yumeyuu/dumbpad/hotswap_rgb_v2/3dmodel/RotarryEncoder_EC12-SW.step

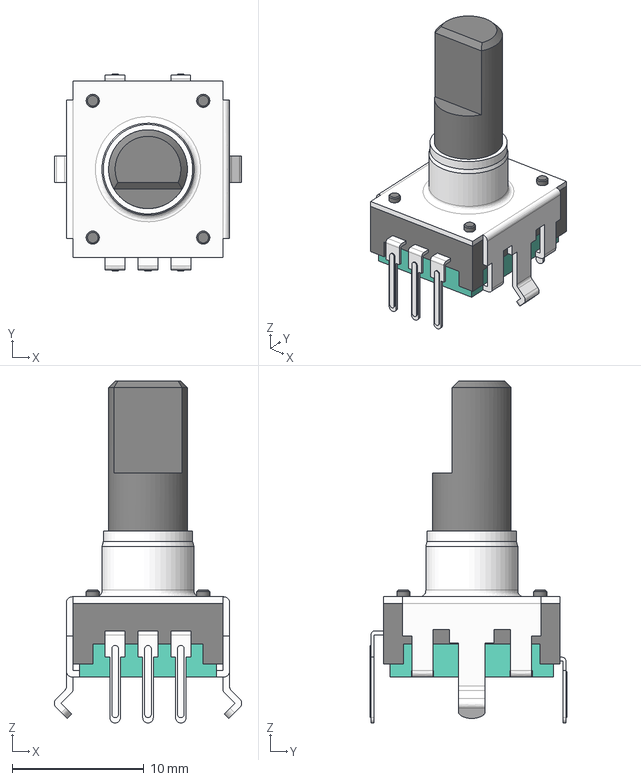
[picture p8: CAD file, 2024-03-14]
hotswap_rgb_v2/3dmodel/RotarryEncoder_EC12-SW.step
14.2 x 15.0 x 26.0 mm
