yumeyuu/dumbpad/hotswap_rgb_v2/3dmodel/OLED-Module-with-Pins.step

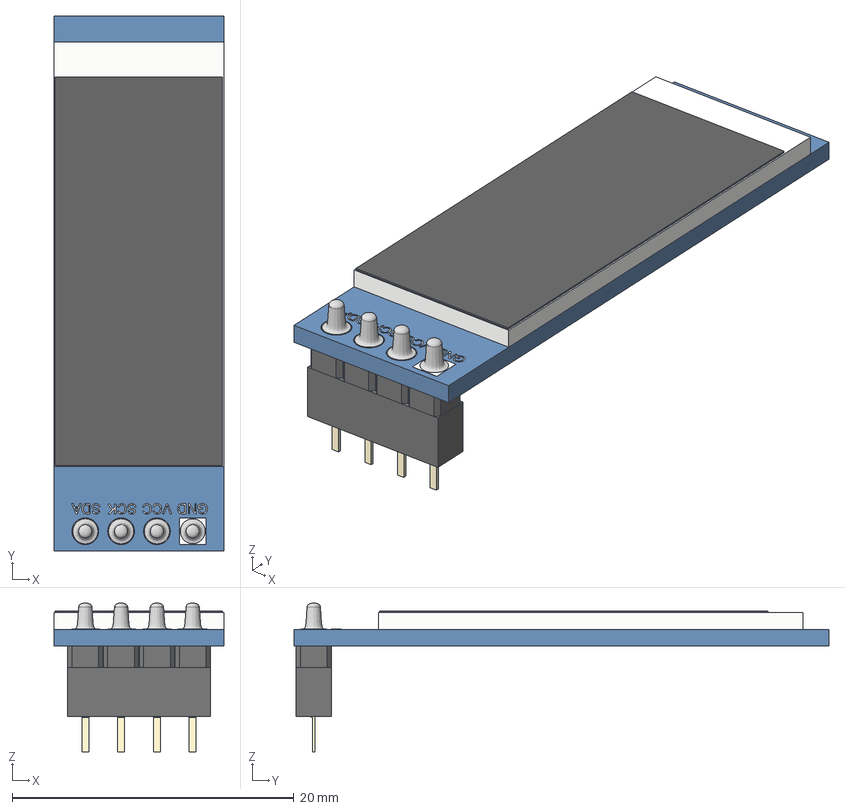
[picture p9: CAD file, 2024-03-14]
hotswap_rgb_v2/3dmodel/OLED-Module-with-Pins.step
12.1 x 37.9 x 10.6 mm
Pin Socket 1x4
Pin Header 1.4
OLED Module
