yumeyuu/dumbpad/hotswap_rgb_v2/3dmodel/Kailh-CherryMX-Socket.step

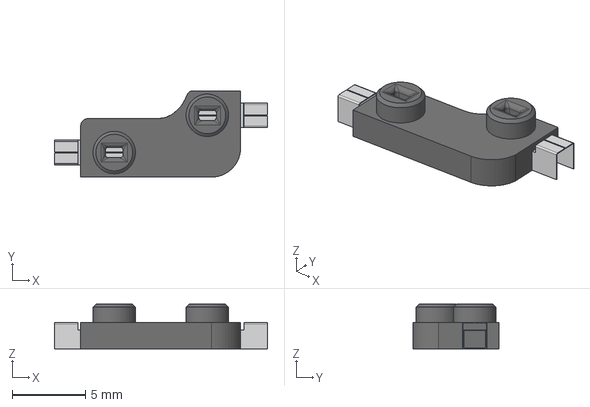
[picture p10: CAD file, 2024-03-14]
hotswap_rgb_v2/3dmodel/Kailh-CherryMX-Socket.step
14.5 x 5.89 x 3.05 mm
