yumeyuu/dumbpad/hotswap_rgb_v2/3dmodel/skrkaee010.stp

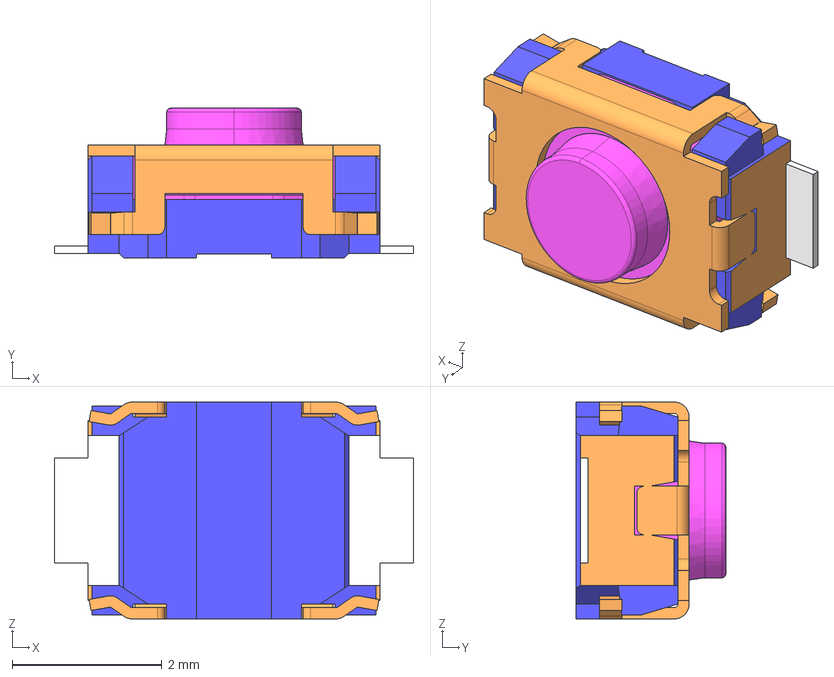
[picture p11: CAD file, 2024-03-14]
hotswap_rgb_v2/3dmodel/skrkaee010.stp
4.80 x 2.00 x 2.90 mm
