yumeyuu/dumbpad/hotswap_rgb_v2/3dmodel/MX Series-Cherry Key.step

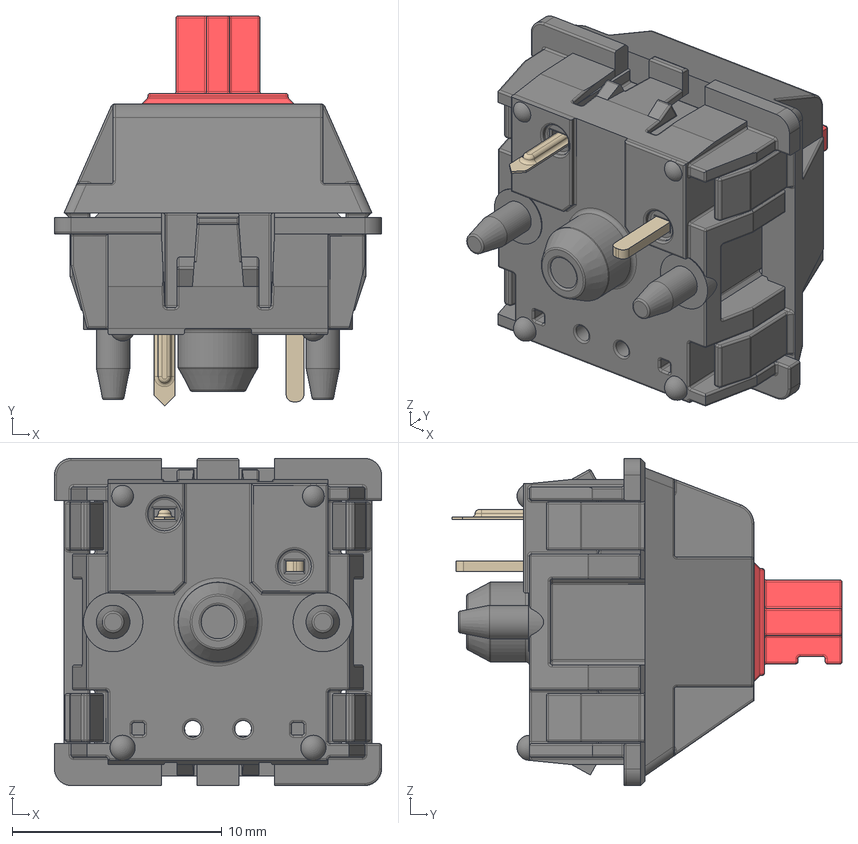
[picture p12: CAD file, 2024-03-14]
hotswap_rgb_v2/3dmodel/MX Series-Cherry Key.step
15.6 x 18.6 x 15.6 mm
