yumeyuu/dumbpad/hotswap_rgb_v2/3dmodel/OLED-Module-with-PinHeader25.step

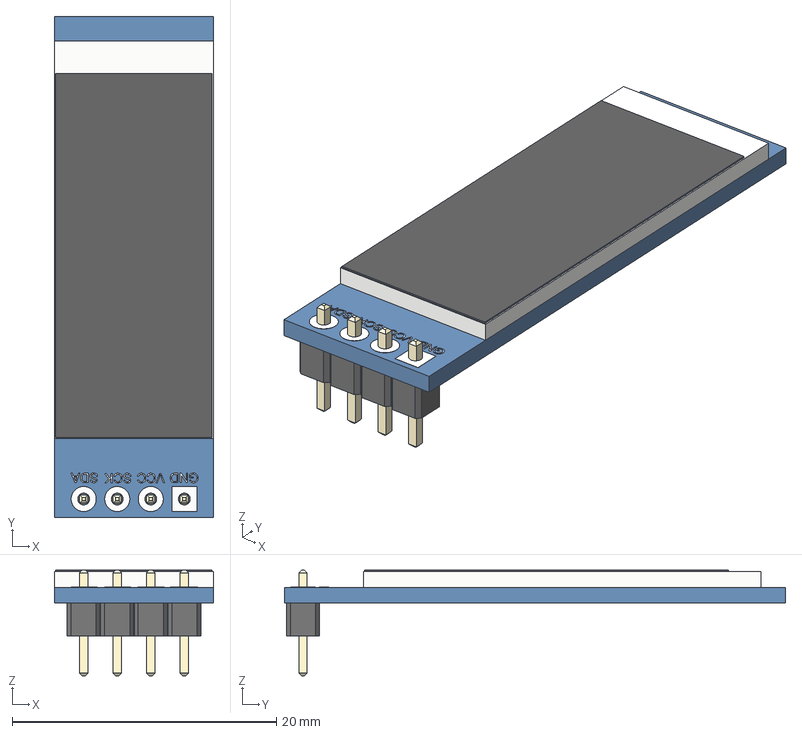
[picture p14: CAD file, 2024-03-14]
hotswap_rgb_v2/3dmodel/OLED-Module-with-PinHeader25.step
12.1 x 37.9 x 8.00 mm
OLED Module
Pin Header 2.5
