yumeyuu/dumbpad/hotswap_rgb_v2/3dmodel/OLED-Module-with-PinHeader15.step

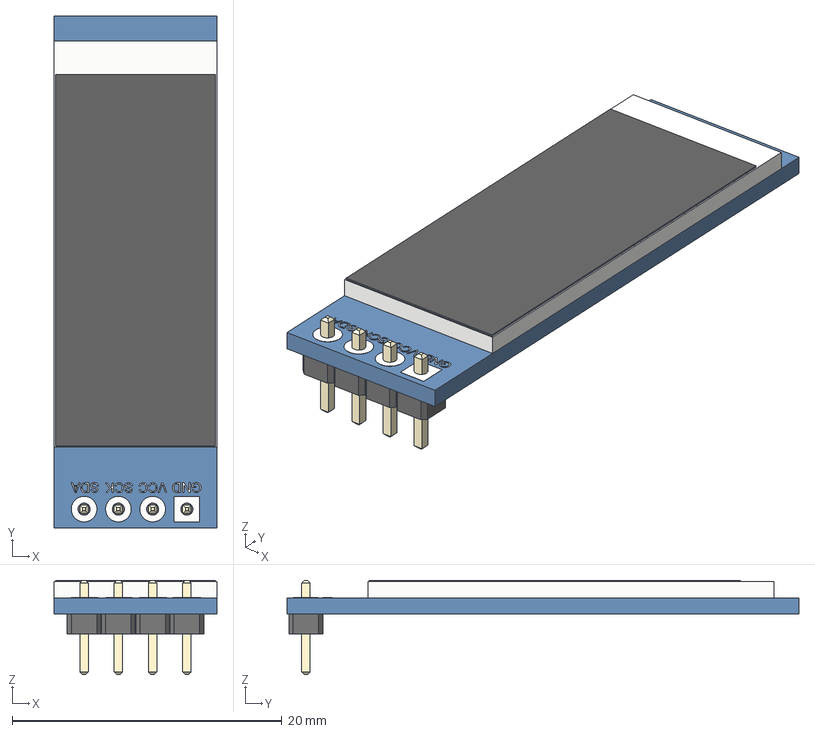
[picture p15: CAD file, 2024-03-14]
hotswap_rgb_v2/3dmodel/OLED-Module-with-PinHeader15.step
12.1 x 37.9 x 7.00 mm
OLED Module
Pin Header 1.5
