yumeyuu/dumbpad/hotswap_rgb_v2/3dmodel/kailh cherry socket soldered.step

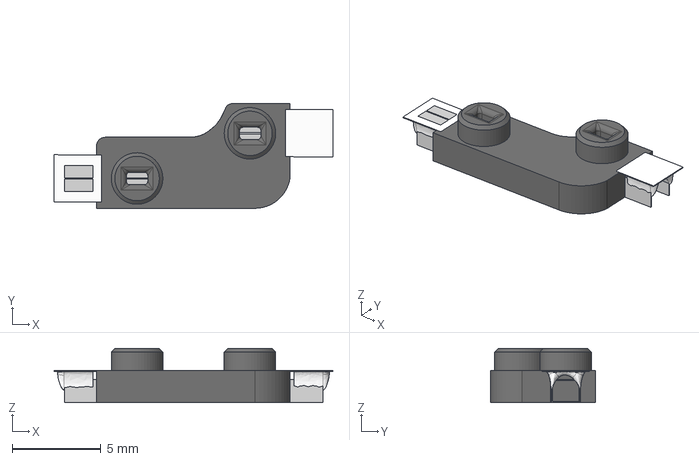
[picture p16: CAD file, 2024-03-14]
hotswap_rgb_v2/3dmodel/kailh cherry socket soldered.step
15.7 x 5.89 x 3.05 mm
