yumeyuu/dumbpad/hotswap_rgb_v2/3dmodel/YS-SK6812MINI-E.step

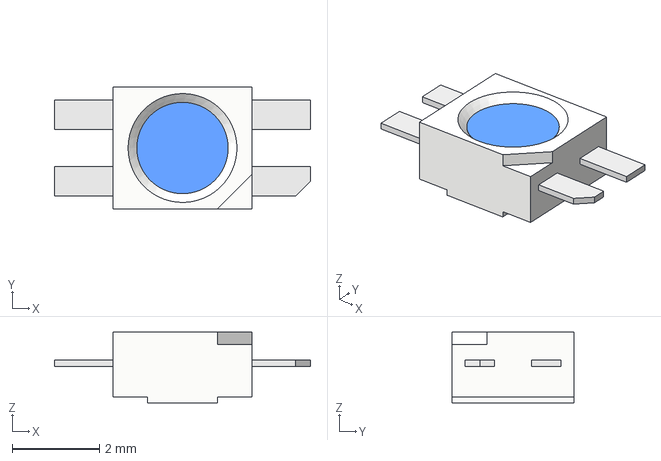
[picture p17: CAD file, 2024-03-14]
hotswap_rgb_v2/3dmodel/YS-SK6812MINI-E.step
5.88 x 2.80 x 1.63 mm
