yumeyuu/dumbpad/(list of files, cad)

Other CAD files:
hotswap_rgb_v2/3dmodel/OLED Module with Soldered.step
hotswap_rgb_v2/3dmodel/OLED Module with Pins Soldered.step
