yumeyuu/dumbpad/hotswap_rgb_v2/pdf/dumbpad.pdf

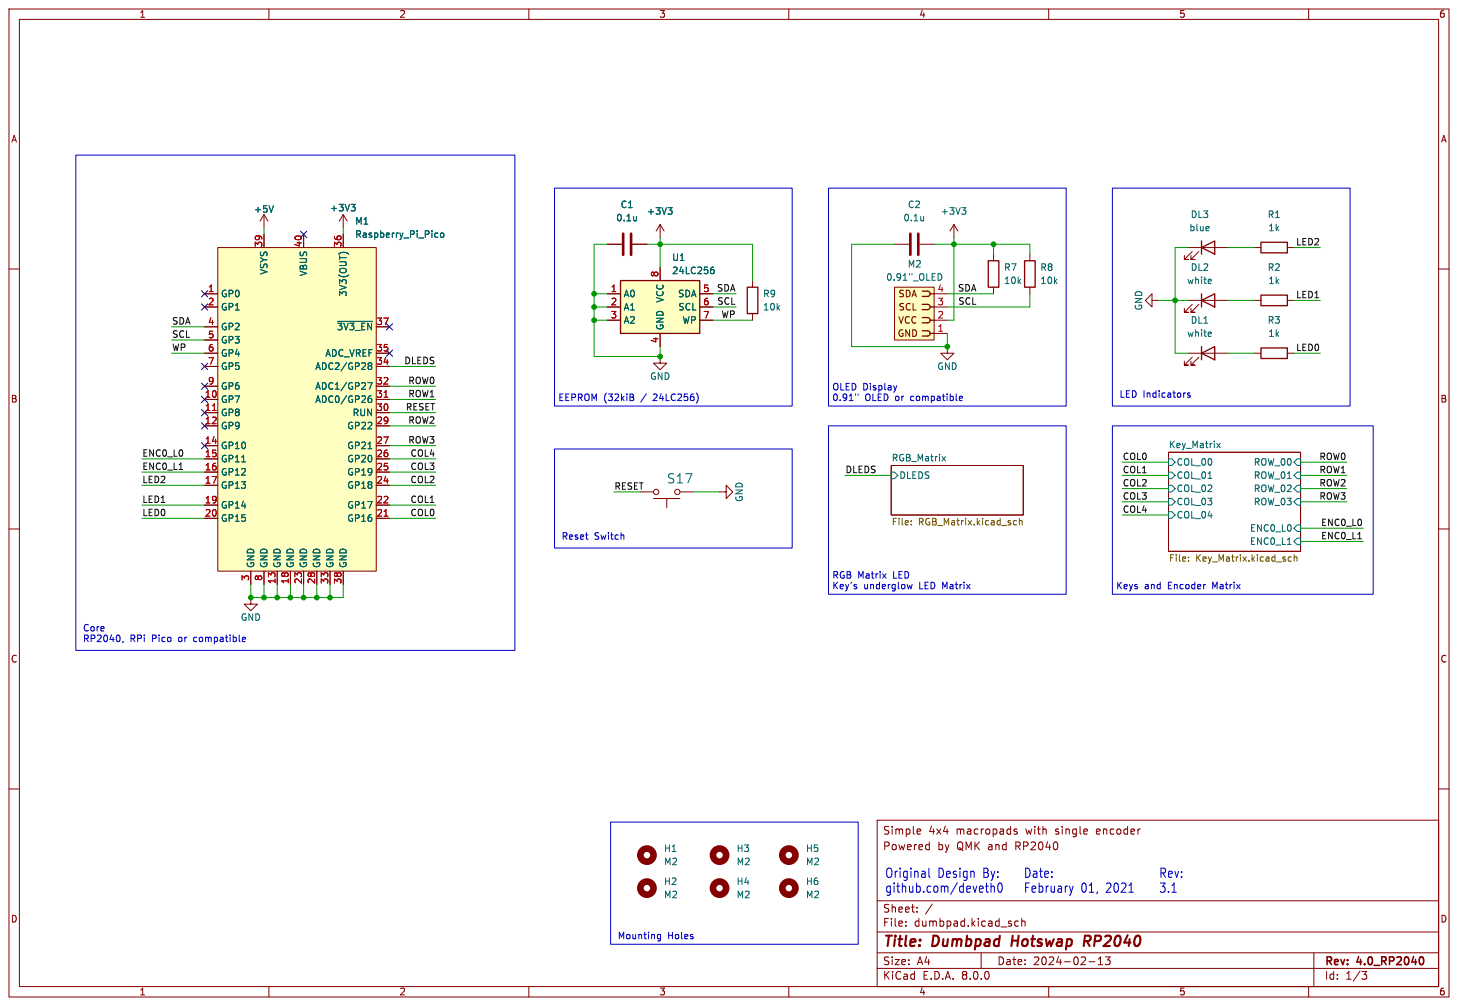
[picture p18: page 1]

4 SDA 5 SCL 6 WP 7 VCC

Id: 1/3 Title: Dumbpad Hotswap RP2040

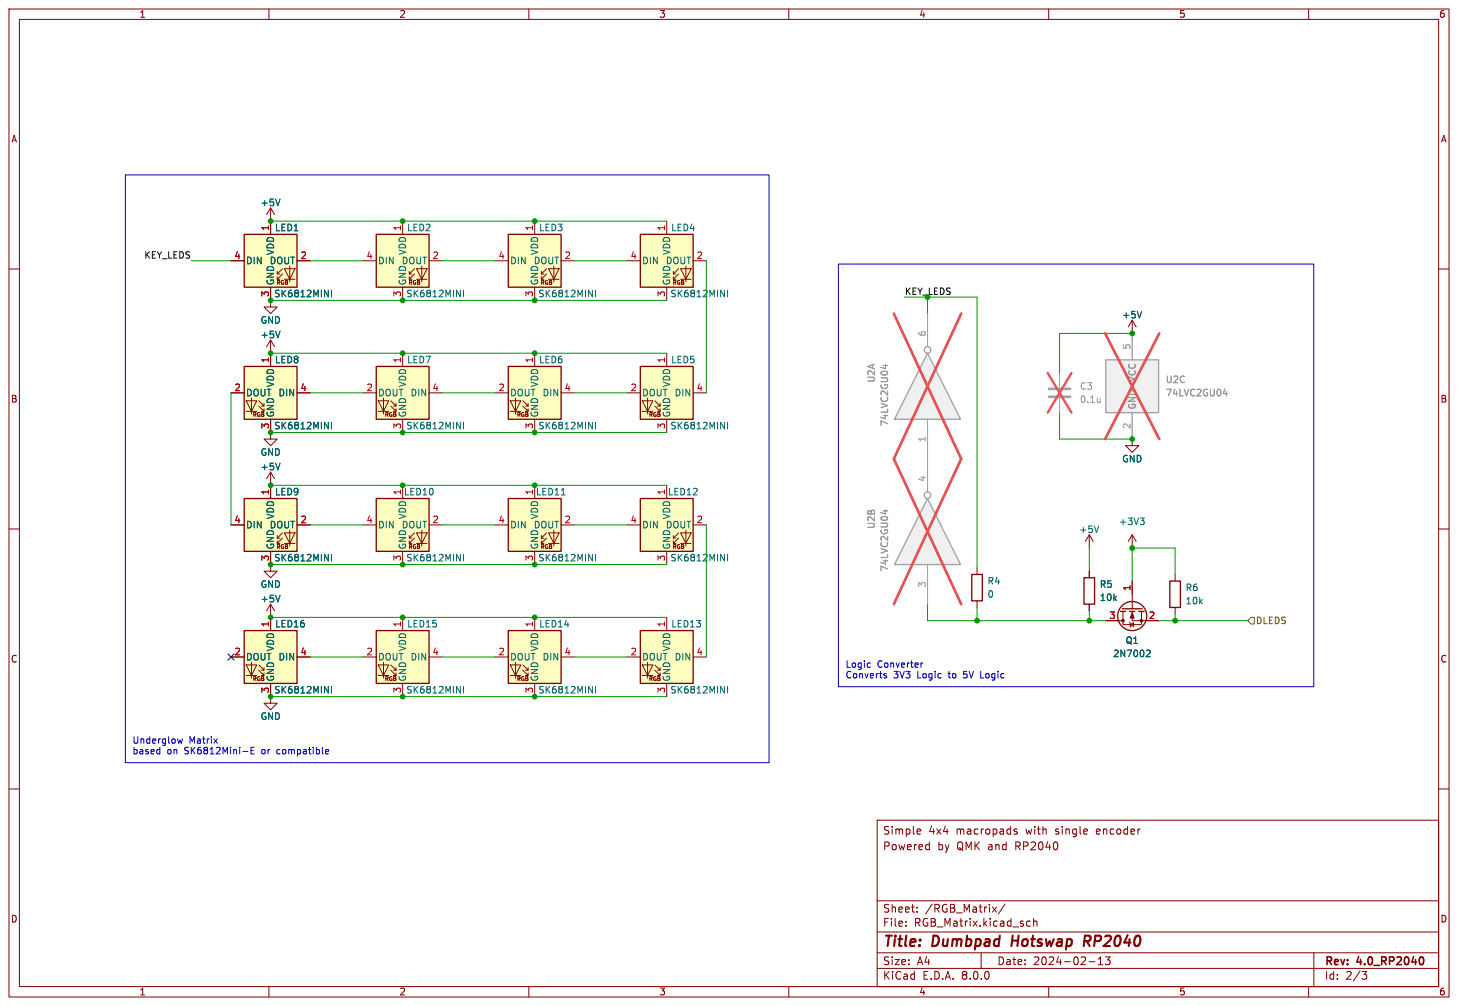
[picture p19: page 2]

Logic Converter Converts 3V3 Logic to 5V Logic

Id: 2/3 Title: Dumbpad Hotswap RP2040

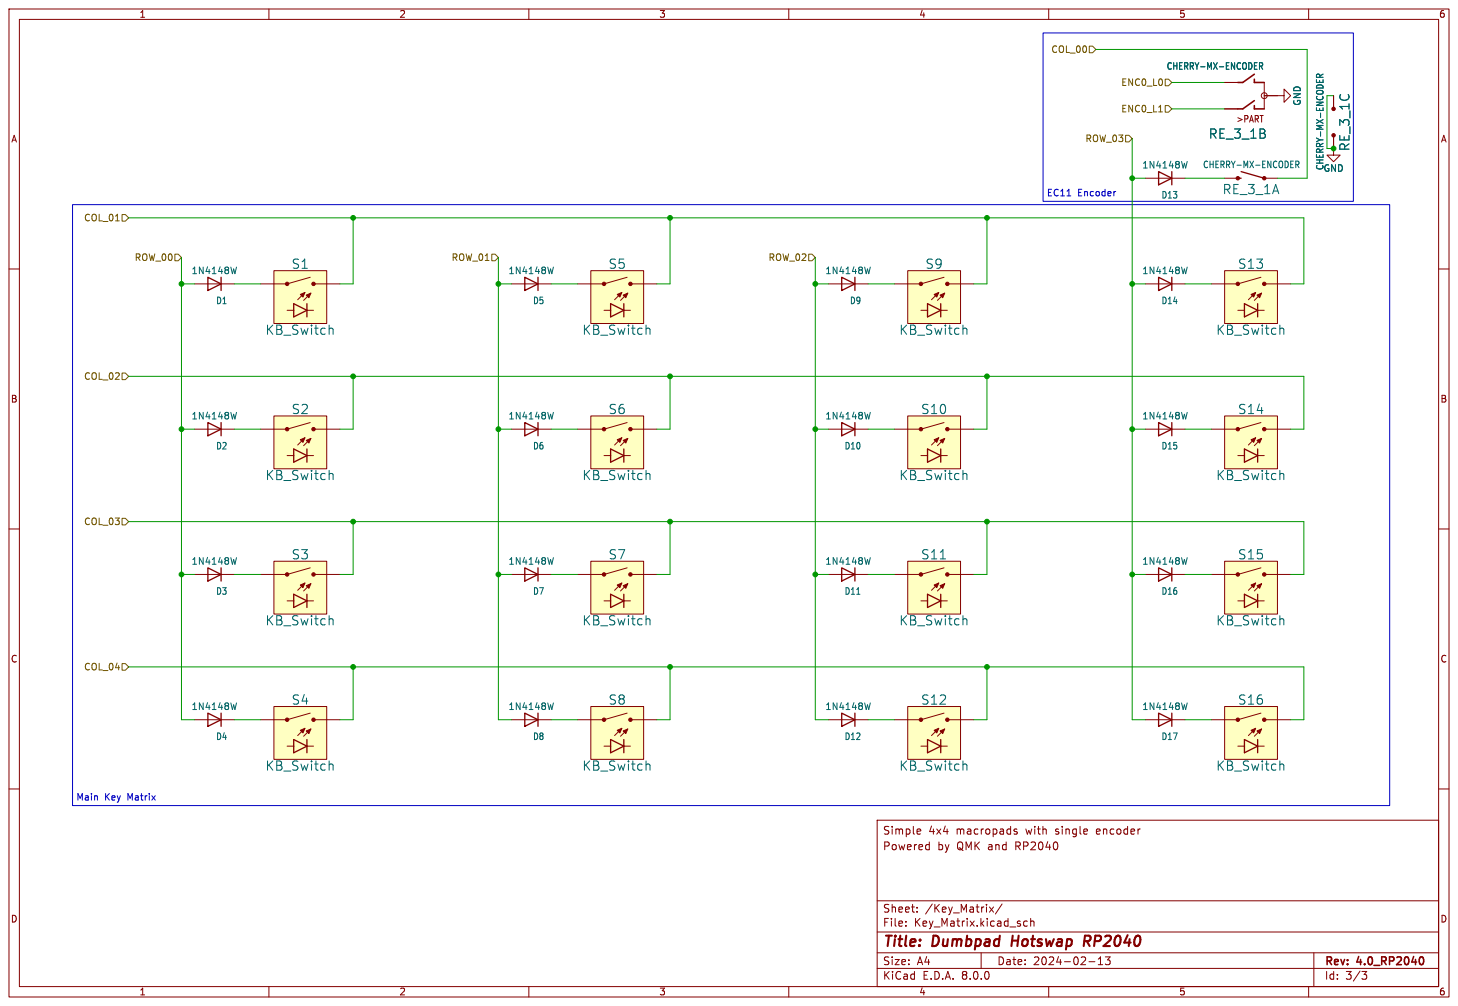
[picture p20: page 3]

Id: 3/3 Title: Dumbpad Hotswap RP2040
