yumeyuu/dumbpad/hotswap_rgb_v2/dumbpad.kicad_pcb

## KiCad design hotswap_rgb_v2/dumbpad.kicad_pcb (2024-03-14)

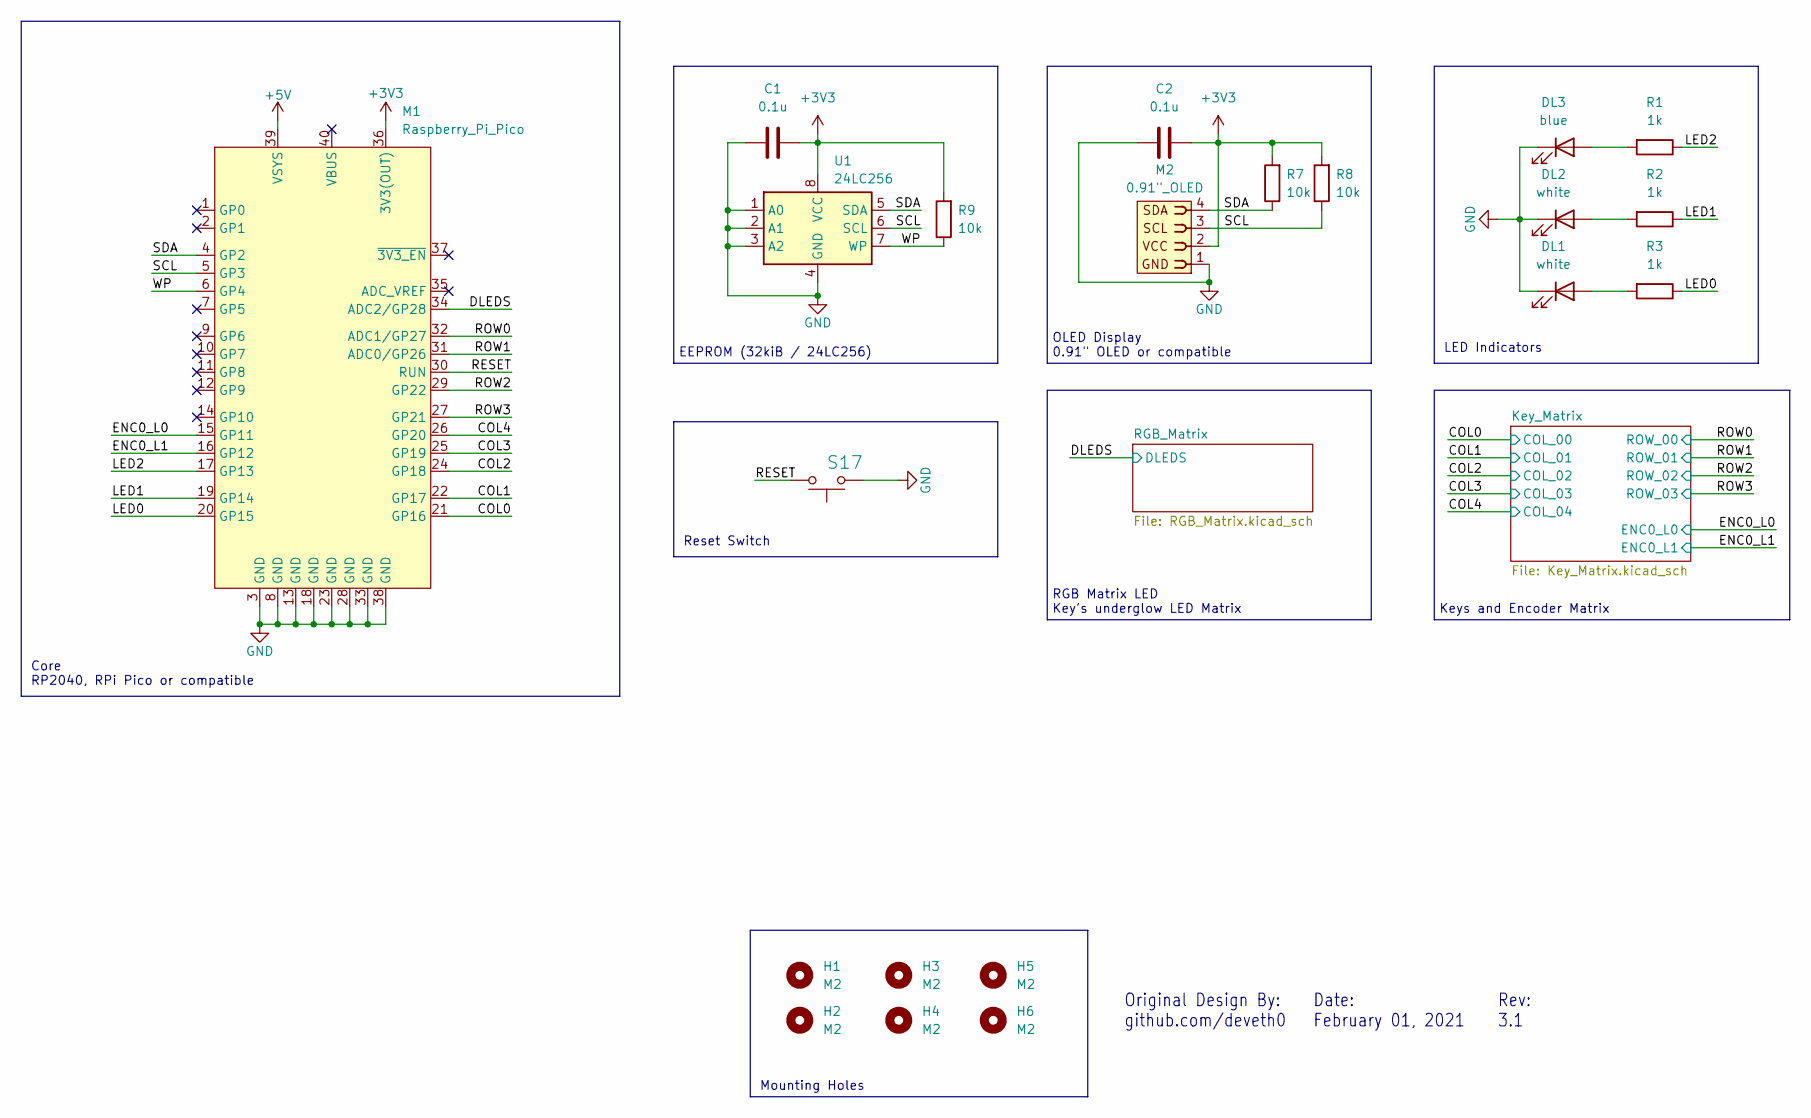
[picture p21: schematic dumbpad.kicad_sch, Dumbpad Hotswap RP2040]

Parts:
C1, C2: 0.1u; C_0603_1608Metric
DL1, DL2: white; LED_0603_1608Metric
DL3: blue; LED_0603_1608Metric
H1, H2, H3, H4, H5, H6: M2; MountingHole_2.2mm_M2_DIN965
M1: Raspberry_Pi_Pico; raspberry_pi_pico_THT
M2: 0.91"_OLED; PinSocket_1x04_P2.54mm_Vertical
R1, R2, R3: 1k; R_0603_1608Metric
R7, R8, R9: 10k; R_0603_1608Metric
S17: SPST Push Button; SW_Push_SPST_NO_Alps_SKRK
U1: 24LC256; SOIC-8_3.9x4.9mm_P1.27mm

Connections:
+3V3: C1.1, C2.1, M1.36 (3V3(OUT)), M2.2, R7.2, R8.2, R9.2, U1.8 (VCC); also elsewhere on the board
+5V: M1.39 (VSYS); also elsewhere on the board
/COL0: M1.21 (GP16); also elsewhere on the board
/COL1: M1.22 (GP17); also elsewhere on the board
/COL2: M1.24 (GP18); also elsewhere on the board
/COL3: M1.25 (GP19); also elsewhere on the board
/COL4: M1.26 (GP20); also elsewhere on the board
/DLEDS: M1.34 (ADC2/GP28); also elsewhere on the board
/ENC0_L0: M1.15 (GP11); also elsewhere on the board
/ENC0_L1: M1.16 (GP12); also elsewhere on the board
/LED0: M1.20 (GP15), R3.1
/LED1: M1.19 (GP14), R2.1
/LED2: M1.17 (GP13), R1.1
/RESET: M1.30 (RUN), S17.2
/ROW0: M1.32 (ADC1/GP27); also elsewhere on the board
/ROW1: M1.31 (ADC0/GP26); also elsewhere on the board
/ROW2: M1.29 (GP22); also elsewhere on the board
/ROW3: M1.27 (GP21); also elsewhere on the board
/SCL: M1.5 (GP3), M2.3, R8.1, U1.6 (SCL)
/SDA: M1.4 (GP2), M2.4, R7.1, U1.5 (SDA)
/WP: M1.6 (GP4), R9.1, U1.7 (WP)
GND: C1.2, C2.2, DL1.1 (K), DL2.1 (K), DL3.1 (K), M1.3 (GND), M1.8 (GND), M1.13 (GND), M1.18 (GND), M1.23 (GND), M1.28 (GND), M1.33 (GND), M1.38 (GND), M2.1, S17.1, U1.1 (A0), U1.2 (A1), U1.3 (A2), U1.4 (GND); also elsewhere on the board
unnamed: DL1.2 (A), R3.2
unnamed: DL2.2 (A), R2.2
unnamed: DL3.2 (A), R1.2

Notes on the sheet:
OLED Display 0.91" OLED or compatible
Keys and Encoder Matrix
Rev: 3.1
Core RP2040, RPi Pico or compatible
Original Design By: github.com/deveth0
LED Indicators
RGB Matrix LED Key's underglow LED Matrix
EEPROM (32kiB / 24LC256)
Reset Switch
Mounting Holes
Date: February 01, 2021

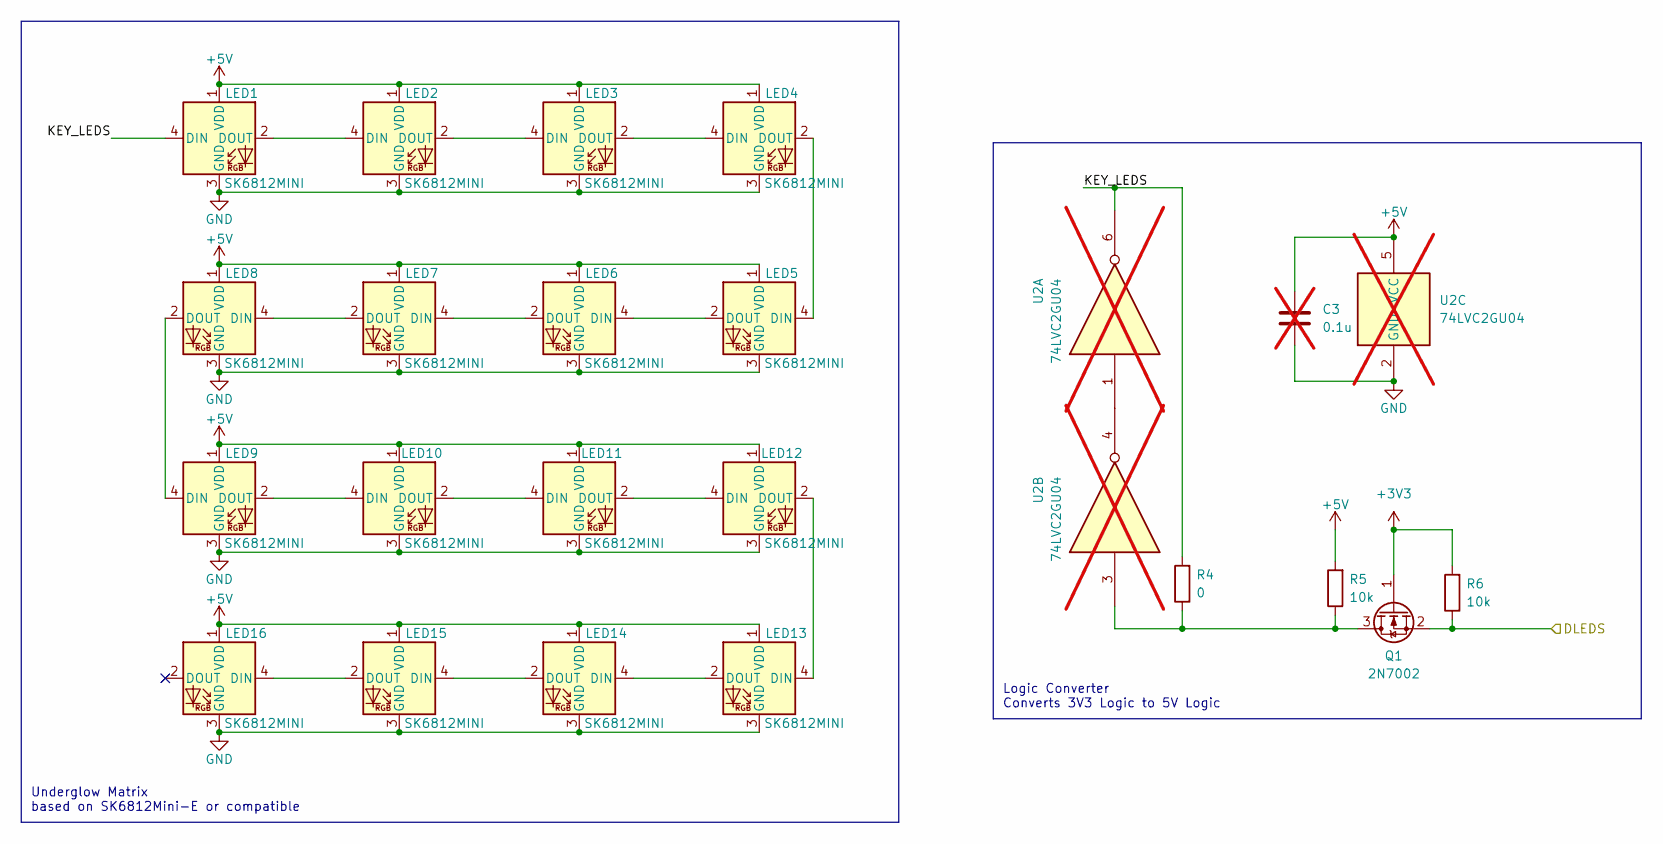
[picture p22: schematic RGB_Matrix.kicad_sch, Dumbpad Hotswap RP2040]

Parts:
C3: 0.1u; C_0603_1608Metric; not fitted
LED1, LED2, LED3, LED4, LED5, LED6, LED7, LED8, LED9, LED10, LED11, LED12, LED13, LED14, LED15, LED16: SK6812MINI; YS-SK6812MINI-E
Q1: 2N7002; SOT-23
R4: 0; R_0603_1608Metric
R5, R6: 10k; R_0603_1608Metric
U2: 74LVC2GU04; SOT-363_SC-70-6; not fitted

Connections:
+3V3: Q1.1 (G), R6.2; also elsewhere on the board
+5V: C3.1, LED1.1 (VDD), LED2.1 (VDD), LED3.1 (VDD), LED4.1 (VDD), LED5.1 (VDD), LED6.1 (VDD), LED7.1 (VDD), LED8.1 (VDD), LED9.1 (VDD), LED10.1 (VDD), LED11.1 (VDD), LED12.1 (VDD), LED13.1 (VDD), LED14.1 (VDD), LED15.1 (VDD), LED16.1 (VDD), R5.2, U2.5 (VCC); also elsewhere on the board
/DLEDS: Q1.2 (S), R6.1; also elsewhere on the board
/RGB_Matrix/KEY_LEDS: LED1.4 (DIN), R4.2, U2.6
GND: C3.2, LED1.3 (GND), LED2.3 (GND), LED3.3 (GND), LED4.3 (GND), LED5.3 (GND), LED6.3 (GND), LED7.3 (GND), LED8.3 (GND), LED9.3 (GND), LED10.3 (GND), LED11.3 (GND), LED12.3 (GND), LED13.3 (GND), LED14.3 (GND), LED15.3 (GND), LED16.3 (GND), U2.2 (GND); also elsewhere on the board
unnamed: LED1.2 (DOUT), LED2.4 (DIN)
unnamed: LED2.2 (DOUT), LED3.4 (DIN)
unnamed: LED3.2 (DOUT), LED4.4 (DIN)
unnamed: LED4.2 (DOUT), LED5.4 (DIN)
unnamed: LED5.2 (DOUT), LED6.4 (DIN)
unnamed: LED6.2 (DOUT), LED7.4 (DIN)
unnamed: LED7.2 (DOUT), LED8.4 (DIN)
unnamed: LED8.2 (DOUT), LED9.4 (DIN)
unnamed: LED9.2 (DOUT), LED10.4 (DIN)
unnamed: LED10.2 (DOUT), LED11.4 (DIN)
unnamed: LED11.2 (DOUT), LED12.4 (DIN)
unnamed: LED12.2 (DOUT), LED13.4 (DIN)
unnamed: LED13.2 (DOUT), LED14.4 (DIN)
unnamed: LED14.2 (DOUT), LED15.4 (DIN)
unnamed: LED15.2 (DOUT), LED16.4 (DIN)
unnamed: Q1.3 (D), R4.1, R5.1, U2.3
unnamed: U2.1, U2.4

Notes on the sheet:
Logic Converter Converts 3V3 Logic to 5V Logic
Underglow Matrix based on SK6812Mini-E or compatible

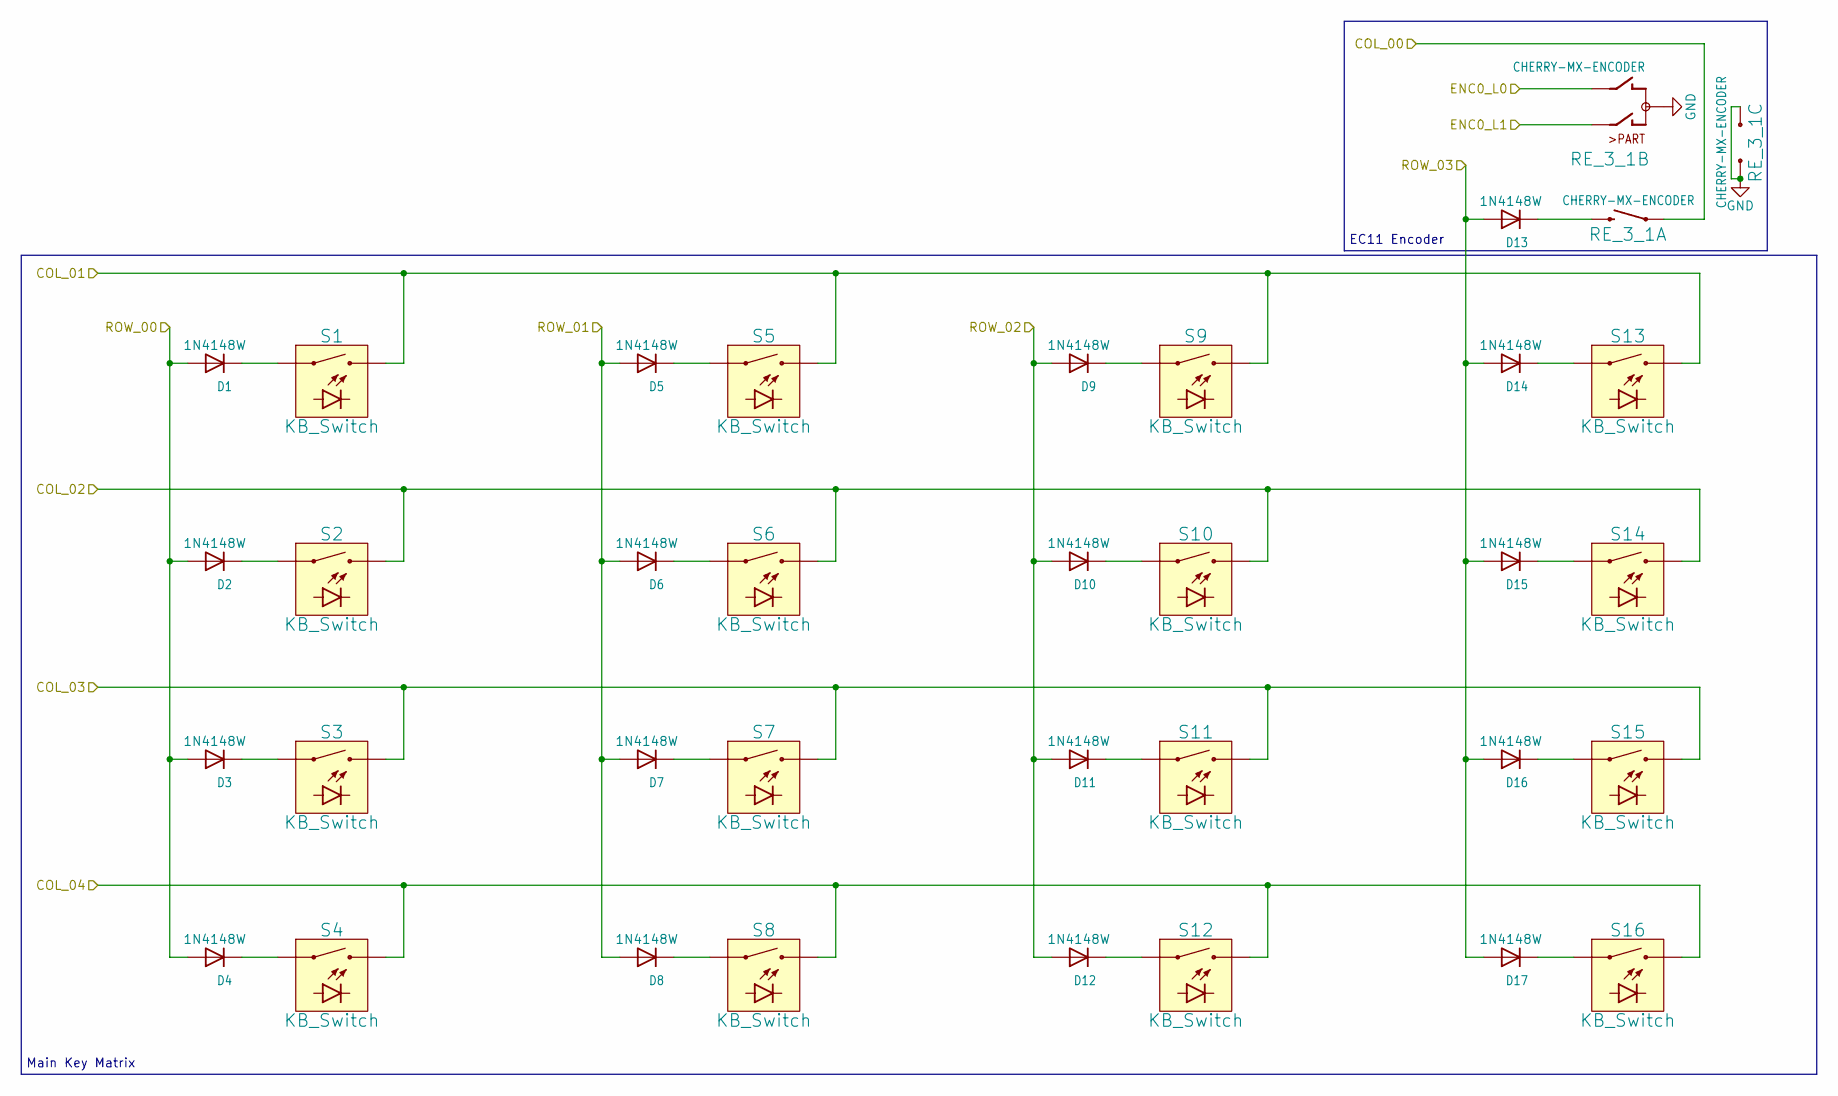
[picture p23: schematic Key_Matrix.kicad_sch, Dumbpad Hotswap RP2040]

Parts:
D1, D2, D3, D4, D5, D6, D7, D8, D9, D10, D11, D12, D13, D14, D15, D16, D17: 1N4148W; D_SOD-123
RE_3_1: CHERRY-MX-ENCODER; RotaryEncoder_Alps_EC11E-Switch_Vertical_H20mm
S1, S2, S3, S4, S5, S6, S7, S8, S9, S10, S11, S12, S13, S14, S15, S16: KB_Switch; Kailh-CPG151101S11_MX_Socket-1.00u

Connections:
/COL0: RE_3_1.S1; also elsewhere on the board
/COL1: S1.S2 (2), S5.S2 (2), S9.S2 (2), S13.S2 (2); also elsewhere on the board
/COL2: S2.S2 (2), S6.S2 (2), S10.S2 (2), S14.S2 (2); also elsewhere on the board
/COL3: S3.S2 (2), S7.S2 (2), S11.S2 (2), S15.S2 (2); also elsewhere on the board
/COL4: S4.S2 (2), S8.S2 (2), S12.S2 (2), S16.S2 (2); also elsewhere on the board
/ENC0_L0: RE_3_1.B; also elsewhere on the board
/ENC0_L1: RE_3_1.A; also elsewhere on the board
/ROW0: D1.2 (A), D2.2 (A), D3.2 (A), D4.2 (A); also elsewhere on the board
/ROW1: D5.2 (A), D6.2 (A), D7.2 (A), D8.2 (A); also elsewhere on the board
/ROW2: D9.2 (A), D10.2 (A), D11.2 (A), D12.2 (A); also elsewhere on the board
/ROW3: D13.2 (A), D14.2 (A), D15.2 (A), D16.2 (A), D17.2 (A); also elsewhere on the board
GND: RE_3_1.C, RE_3_1.MP; also elsewhere on the board
unnamed: D1.1 (K), S1.S1 (1)
unnamed: D2.1 (K), S2.S1 (1)
unnamed: D3.1 (K), S3.S1 (1)
unnamed: D4.1 (K), S4.S1 (1)
unnamed: D5.1 (K), S5.S1 (1)
unnamed: D6.1 (K), S6.S1 (1)
unnamed: D7.1 (K), S7.S1 (1)
unnamed: D8.1 (K), S8.S1 (1)
unnamed: D9.1 (K), S9.S1 (1)
unnamed: D10.1 (K), S10.S1 (1)
unnamed: D11.1 (K), S11.S1 (1)
unnamed: D12.1 (K), S12.S1 (1)
unnamed: D13.1 (K), RE_3_1.S2
unnamed: D14.1 (K), S13.S1 (1)
unnamed: D15.1 (K), S14.S1 (1)
unnamed: D16.1 (K), S15.S1 (1)
unnamed: D17.1 (K), S16.S1 (1)

Notes on the sheet:
Main Key Matrix
EC11 Encoder

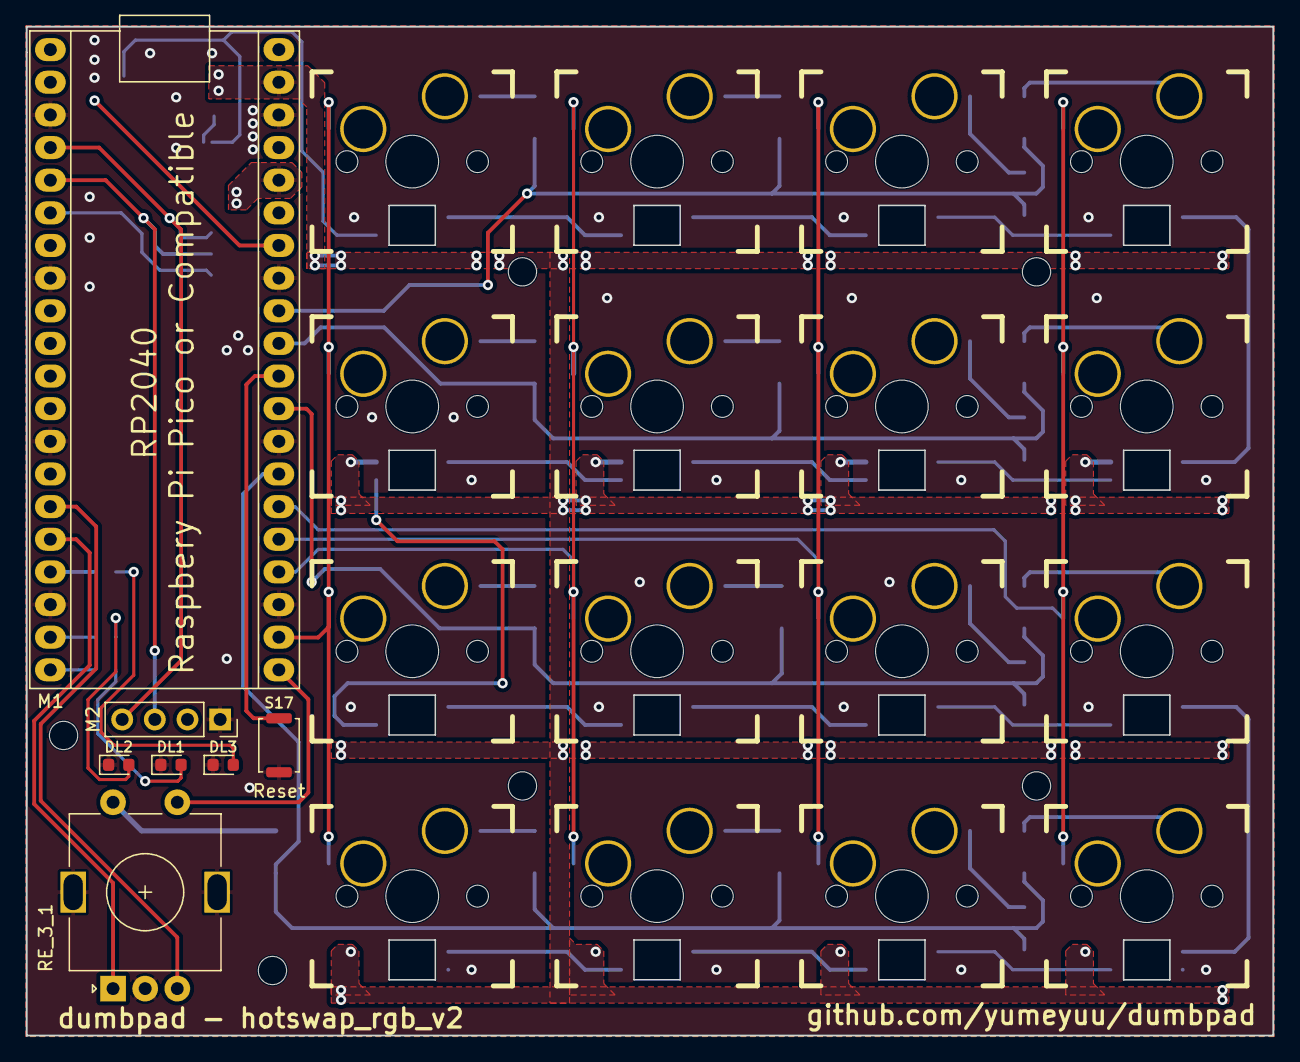
[picture p24: board dumbpad.kicad_pcb from above]

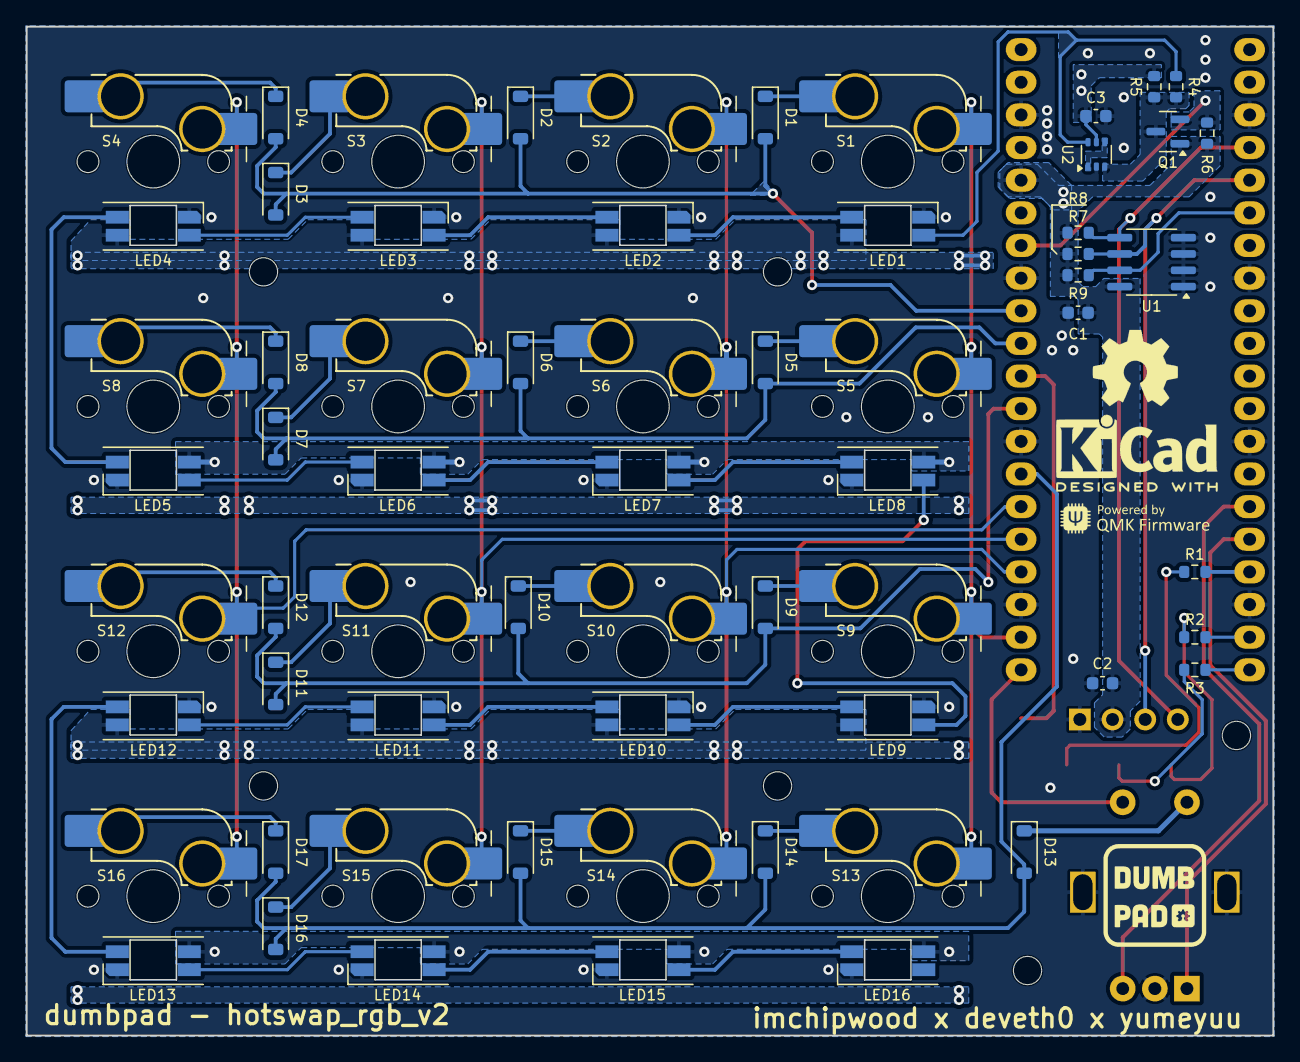
[picture p25: board dumbpad.kicad_pcb from below]

Board: 2 copper layers, 97.0 x 78.5 mm, 78 parts (49 on the bottom side), 60 nets.

Other parts of the board:
G1: KiCad-Logo2_5mm_SilkScreen
